DaVNe77/Praca-in-ynierska---dokumentacja/Schemat SCH/Shield v38.pdf

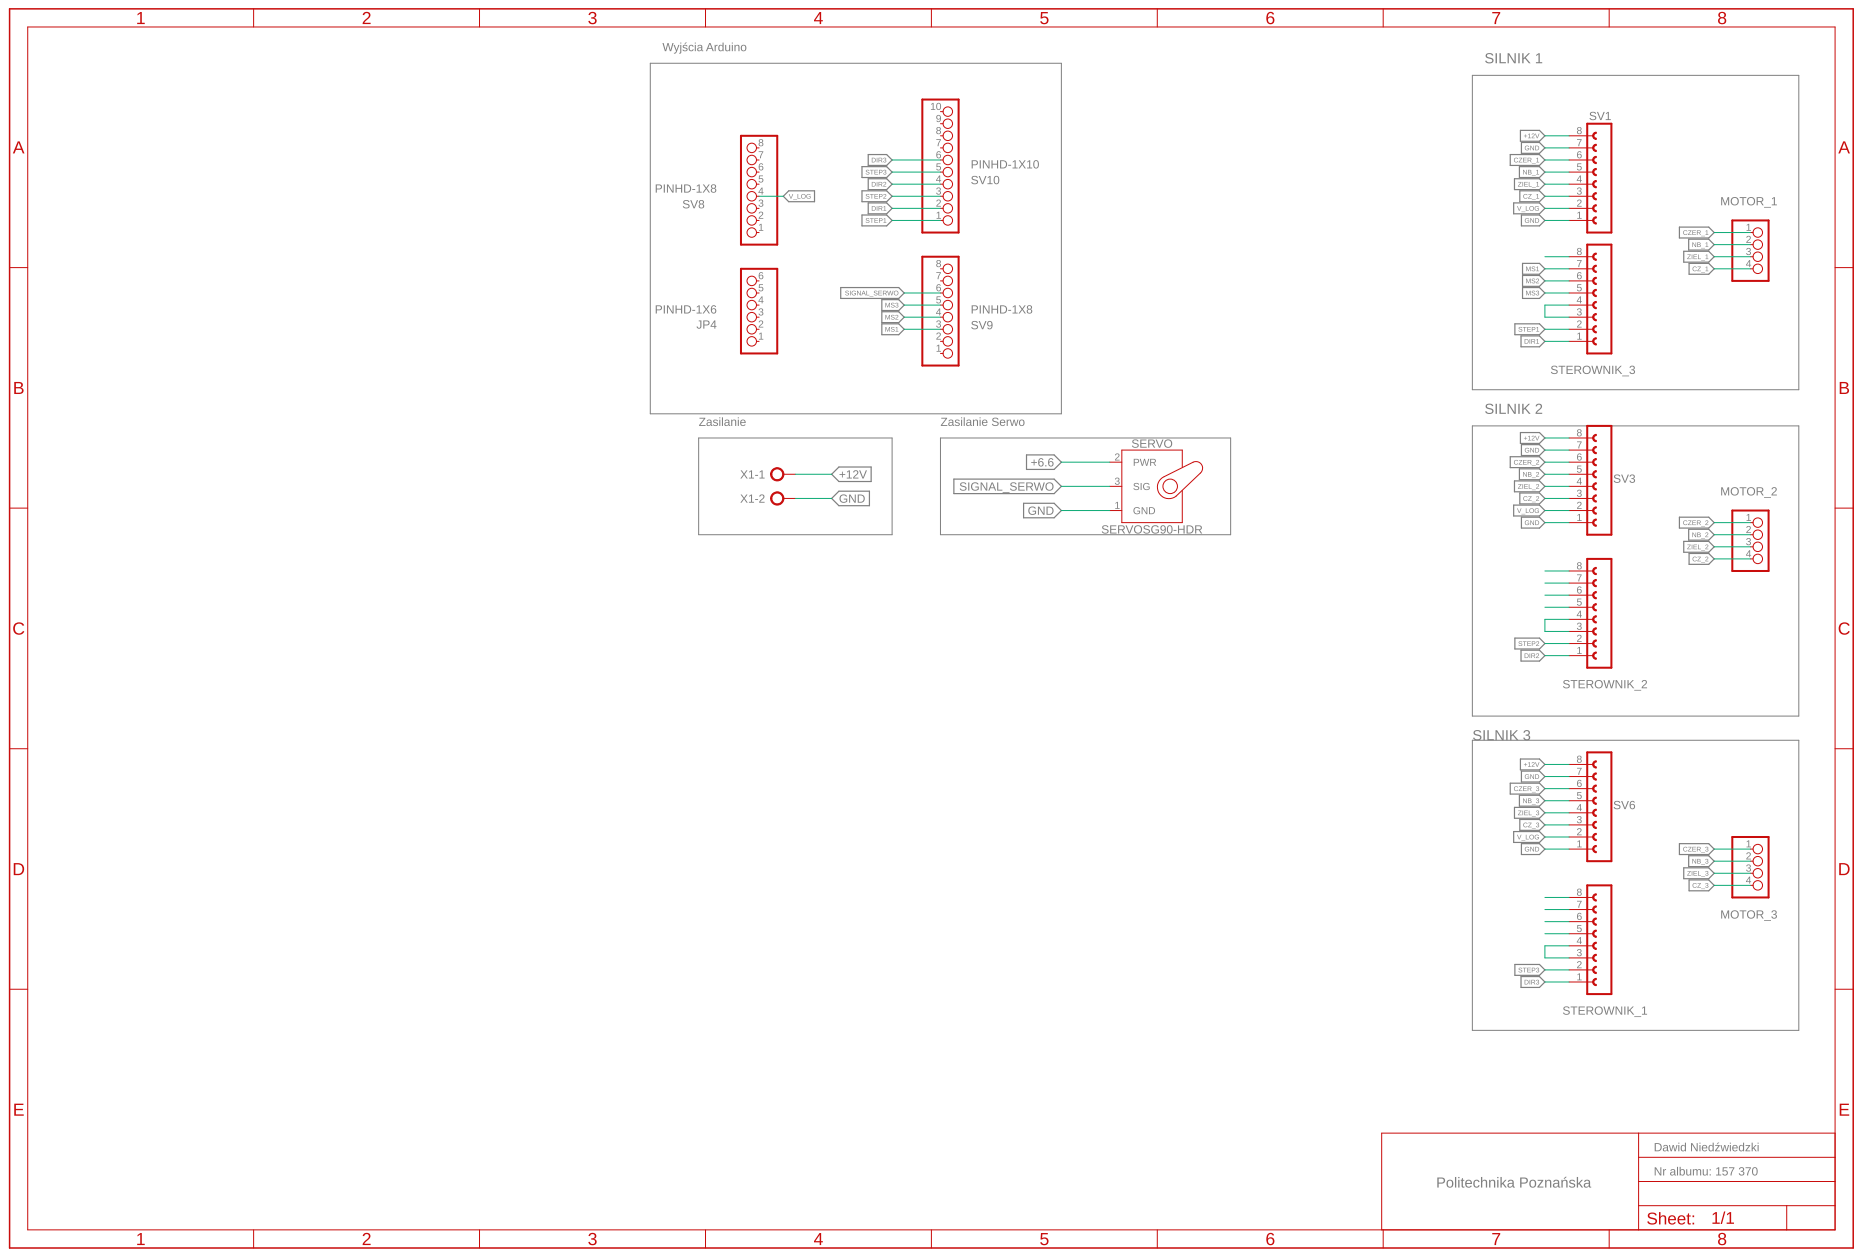
[picture p1: page 1]
