DaVNe77/Praca-in-ynierska---dokumentacja/Rysunki_złożeniowe/Podstawa_złożenie.pdf

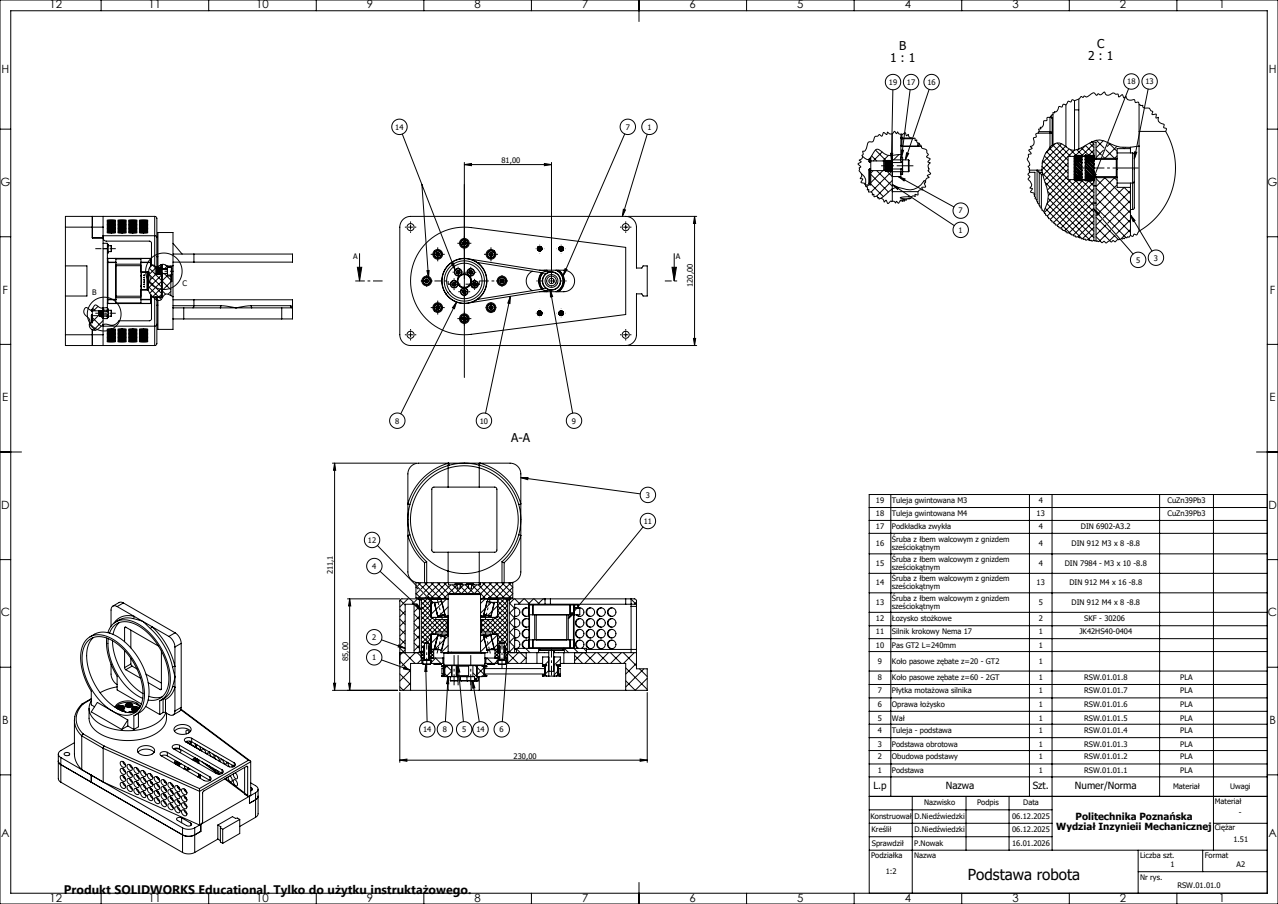
[picture p2: page 1]
Nr rys.

19 | Tuleja gwintowana M3 | 4 | | CuZn39Pb3
18 | Tuleja gwintowana M4 | 13 | | CuZn39Pb3
17 | Podkładka zwykła | 4 | DIN 6902-A3.2
16 | Śruba z łbem walcowym z gnizdem sześciokątnym | 4 | DIN 912 M3 x 8 -8.8
15 | Śruba z łbem walcowym z gnizdem sześciokątnym | 4 | DIN 7984 - M3 x 10 -8.8
14 | Śruba z łbem walcowym z gnizdem sześciokątnym | 13 | DIN 912 M4 x 16 -8.8
13 | Śruba z łbem walcowym z gnizdem sześciokątnym | 5 | DIN 912 M4 x 8 -8.8
12 | Łozysko stożkowe | 2 | SKF - 30206
11 | Silnik krokowy Nema 17 | 1 | JK42HS40-0404
10 | Pas GT2 L=240mm | 1
9 | Koło pasowe zębate z=20 - GT2 | 1
8 | Koło pasowe zębate z=60 - 2GT | 1 | RSW.01.01.8 | PLA
7 | Płytka motażowa silnika | 1 | RSW.01.01.7 | PLA
6 | Oprawa łożysko | 1 | RSW.01.01.6 | PLA
5 | Wał | 1 | RSW.01.01.5 | PLA
4 | Tuleja - podstawa | 1 | RSW.01.01.4 | PLA
3 | Podstawa obrotowa | 1 | RSW.01.01.3 | PLA
2 | Obudowa podstawy | 1 | RSW.01.01.2 | PLA
1 | Podstawa | 1 | RSW.01.01.1 | PLA
L.p | Nazwa | Szt. | Numer/Norma | Materiał | Uwagi

Nazwisko | Podpis | Data | Politechnika Poznańska Wydział Inzynieii Mechanicznej | Materiał -

Konstruował | D.Niedźwiedzki | | 06.12.2025
Kreślił | D.Niedźwiedzki | | 06.12.2025 | | Ciężar 1.51
Sprawdził | P.Nowak | | 16.01.2026
Podziałka 1:2 | Nazwa Podstawa robota | Liczba szt. 1 | Format A2

Produkt SOLIDWORKS Educational. Tylko do użytku instruktażowego.
