DaVNe77/Praca-in-ynierska---dokumentacja/Rysunki_złożeniowe/Przekładnia_cykloidalna_złożenie.pdf

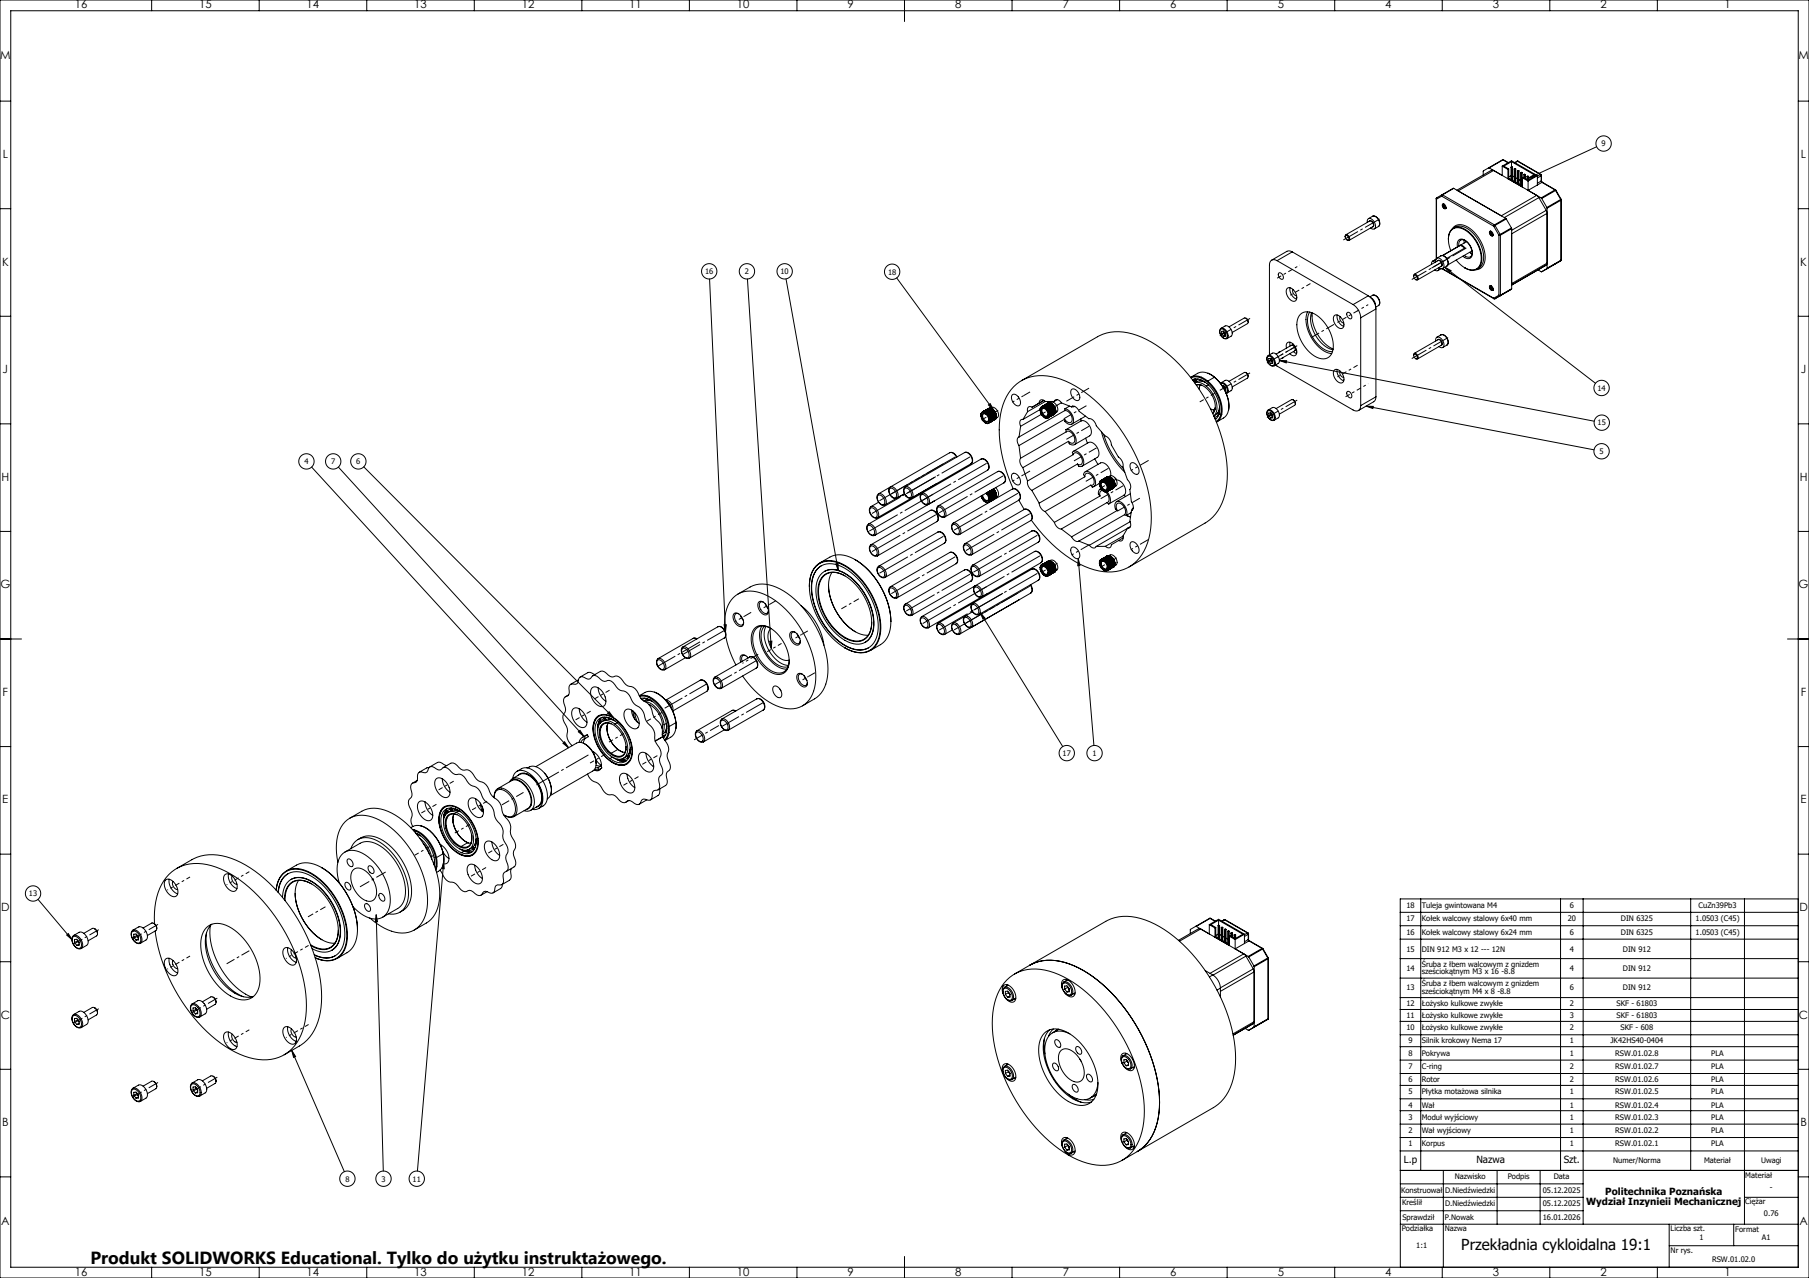
[picture p3: page 1]
Nr rys.; Przekładnia cykloidalna 19:1

18 | Tuleja gwintowana M4 | 6 | | CuZn39Pb3
17 | Kołek walcowy stalowy 6x40 mm | 20 | DIN 6325 | 1.0503 (C45)
16 | Kołek walcowy stalowy 6x24 mm | 6 | DIN 6325 | 1.0503 (C45)
15 | DIN 912 M3 x 12 --- 12N | 4 | DIN 912
14 | Śruba z łbem walcowym z gnizdem sześciokątnym M3 x 16 -8.8 | 4 | DIN 912
13 | Śruba z łbem walcowym z gnizdem sześciokątnym M4 x 8 -8.8 | 6 | DIN 912
12 | Łożysko kulkowe zwykłe | 2 | SKF - 61803
11 | Łożysko kulkowe zwykłe | 3 | SKF - 61803
10 | Łożysko kulkowe zwykłe | 2 | SKF - 608
9 | Silnik krokowy Nema 17 | 1 | JK42HS40-0404
8 | Pokrywa | 1 | RSW.01.02.8 | PLA
7 | C-ring | 2 | RSW.01.02.7 | PLA
6 | Rotor | 2 | RSW.01.02.6 | PLA
5 | Płytka motażowa silnika | 1 | RSW.01.02.5 | PLA
4 | Wał | 1 | RSW.01.02.4 | PLA
3 | Moduł wyjściowy | 1 | RSW.01.02.3 | PLA
2 | Wał wyjściowy | 1 | RSW.01.02.2 | PLA
1 | Korpus | 1 | RSW.01.02.1 | PLA
L.p | Nazwa | Szt. | Numer/Norma | Materiał | Uwagi
Nazwisko | Podpis | Data | Politechnika Poznańska Wydział Inzynieii Mechanicznej | Materiał -

Konstruował | D.Niedźwiedzki | | 05.12.2025
Kreślił | D.Niedźwiedzki | | 05.12.2025 | | Ciężar 0.76
Sprawdził | P.Nowak | | 16.01.2026
Podziałka 1:1 | Nazwa | Liczba szt. | Format A1

Produkt SOLIDWORKS Educational. Tylko do użytku instruktażowego.
